Pranav-s19/Autonomous-Robotic-Arm-for-Warehouse-Logistics-Using-TinyML/README.md

# Autonomous-Robotic-Arm-for-Warehouse-Logistics-Using-TinyML

***Public Project Link:***  https://studio.edgeimpulse.com/public/827532/live

***Project Demo Video:*** https://www.youtube.com/watch?v=fI1cnPdgFPI

## Introduction

Modern warehouses require fast, reliable, and intelligent sorting systems to manage increasing demand. Traditional automated solutions are often expensive, power-hungry, and rely heavily on cloud connectivity, making them unsuitable for small-scale industries or secure in-house environments.
This project presents a TinyML-powered autonomous robotic arm capable of detecting, classifying, and sorting boxes using only low-power microcontrollers and edge intelligence.

## Motivation

The primary motivation behind this project is to build a cost-efficient, energy-efficient, and memory-efficient autonomous warehouse solution that operates entirely on edge devices. With an increasing need for secure in-house computation—especially in industries where data privacy is critical—this system eliminates cloud dependency while maintaining smart functionality.
The entire prototype has been developed using minimal resources and low-cost components, proving that advanced warehouse automation is achievable even with limited budgets. This project showcases how TinyML and embedded systems can enable scalable, secure, and sustainable industrial automation.

## Hardware Selection

- ESP32-CAM (AI Thinker)
- ESP32 XIAO S3
- Arduino Nano
- 28BYJ-48 Stepper Motor DC 5V  
- MG945 Servo 
- MG90S Servo 
- SG90 Servo 
- LDR Sensors (x2)
- 10kΩ Variable Resistors (x2)
- Red LED 
- Yellow LED 
- 3mm Sunboard Sheet
- Jumper Wires
- Breadboard (x2)
- USB Data Cables
- Power Supply (5V 3A)
- DC–DC Voltage Converter (5V → 3.3V)
- LM2596S Buck Converter

## Software & Platforms

- Arduino IDE
- Edge Impulse

#### The project follows a two-phase architecture: 
>In the first phase, development of object detection model in Edge Impulse to classify apple and mango boxes using the ESP32-CAM. 

>In the second phase, object detection model is integrated into a coordinated multi-microcontroller system that handles decision-making and autonomous robotic arm movement.

```bash
Architecture
│
├── Object detection Model Development
│   ├── Data Acquisition
│   ├── Impulse Design
│   └── Model Training & Deployment
│
└── Hardware Integration & Application
    ├── ESP32-CAM (Inference)
    ├── ESP32 XIAO S3 (Decision Control)
    └── Arduino Nano + Robotic Arm (Motion Control)
```

## Object Detection Model Development

### Data Acquisition
I collected my dataset directly using the ESP32-CAM, which I configured as a small web server using the EloquentESP32CAM library. I captured at least 130 images per class (apple and mango boxes) under constant lighting and a clean background. The images were taken at a resolution of 240×240 px, which is suitable for fast training and edge deployment. After capturing, I downloaded the images and uploaded them to Edge Impulse for labeling.

For more details on ESP32-CAM data collection: https://eloquentarduino.com/posts/esp32-cam-object-detection

>  **Note:** while capturing images, I turned on Built-in LED flash for consistent lighting.

In the Labelling queue, all the raw images are shown, and we need to drag and drop the markings and label the boxes accordingly.

You can learn more about the labeling queue here: https://docs.edgeimpulse.com/studio/projects/data-acquisition/labeling-queue.

### Impulse Design

I selected the Image input block with a resolution of 96×96 and chose Fit longest axis. Smaller size makes the model lightweight and faster to run on the ESP32-CAM while still keeping enough detail. for classifying apple and mango boxes.

For the learning block, I selected Object Detection (Images).

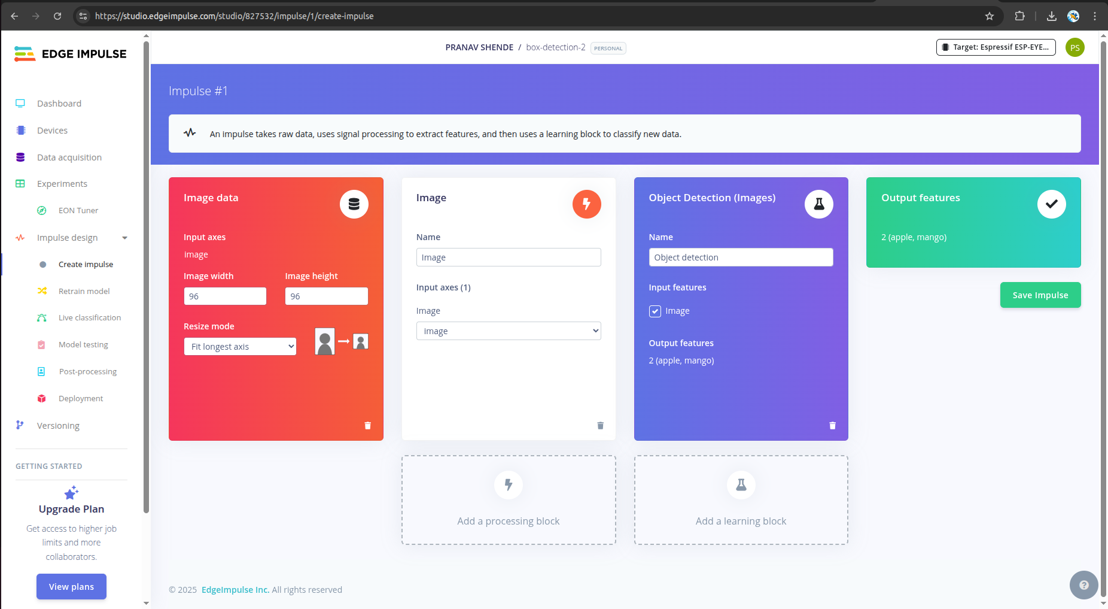
[picture p1: images/create impulse.png]
<ln/>

Then on the Image section, I selected the color depth as “ Grayscale”.<br/>
Grayscale reduces memory usage and speeds up inference while still keeping enough features for classification.

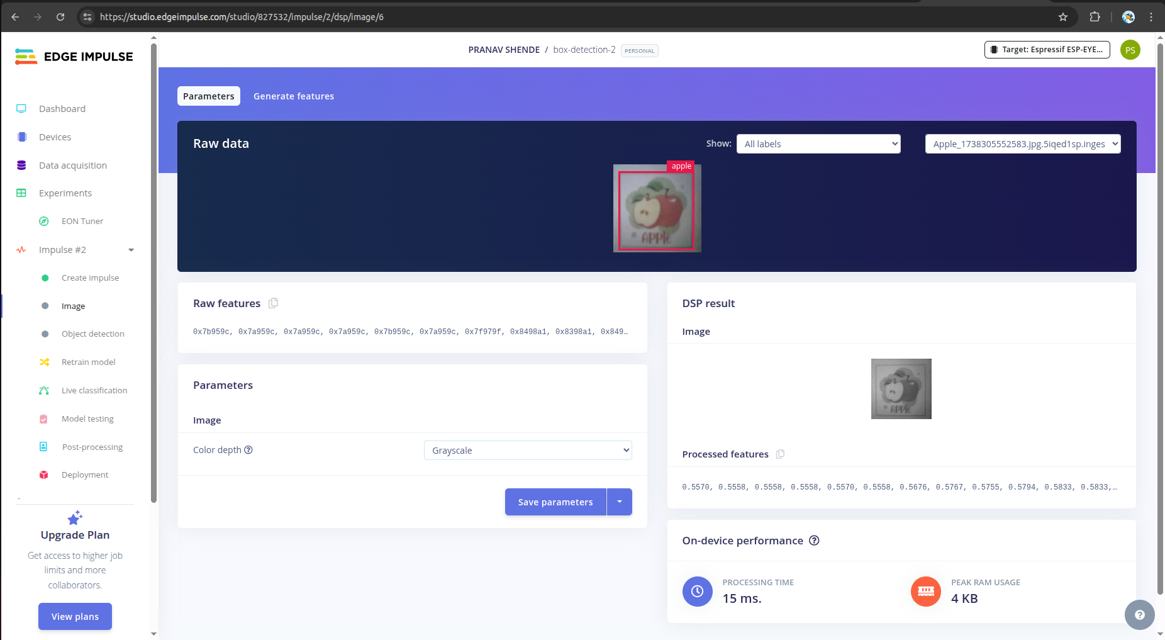
[picture p2: images/grayscale.png]
<ln/>

### Model Training

I trained the model for 40 epochs with a learning rate of 0.001, which gave a good balance between speed and stability.<br/>
In the Object detection section, I have selected the FOMO model — FOMO (Faster Objects, More Objects) MobileNetV2 0.35 

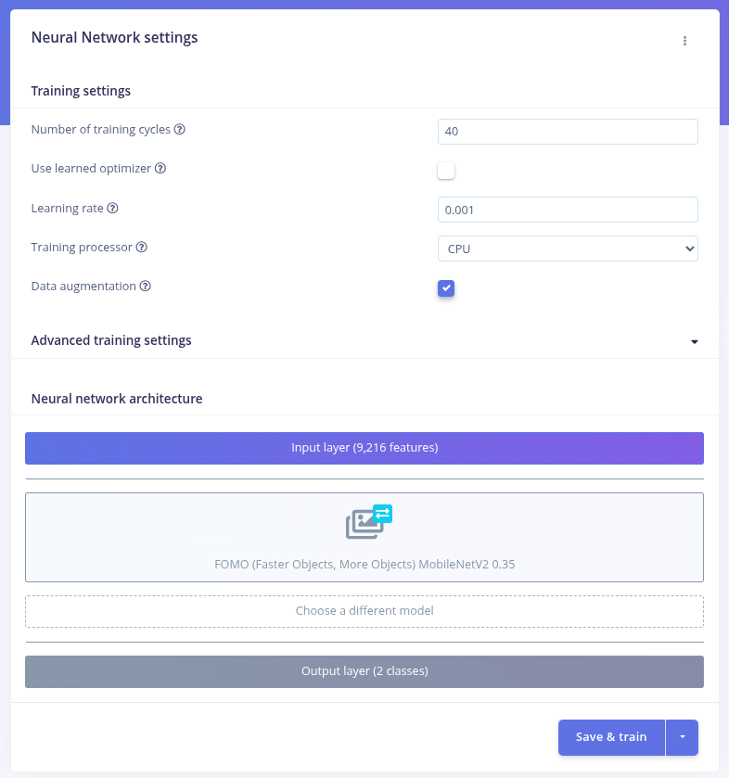
[picture p3: images/training-param.png]
 <ln/>

After training, the model achieved an accuracy of around 97.6% on the validation set, which is sufficient for reliable classification in this application.

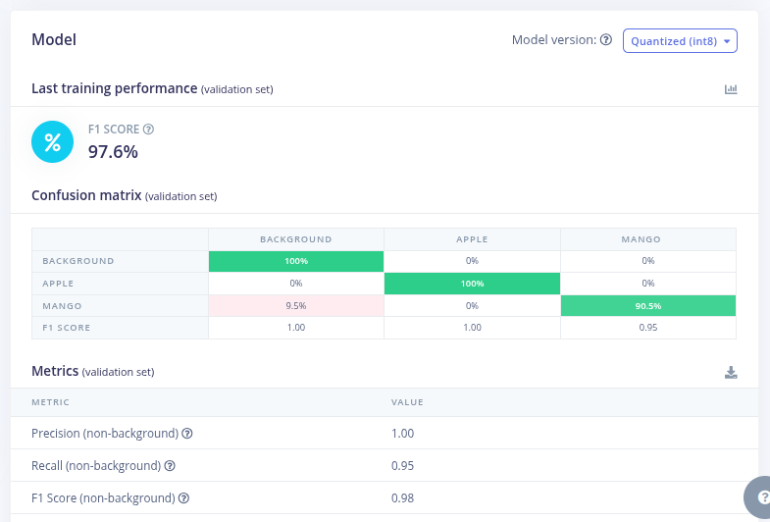
[picture p4: images/training output.png]


### Model Testing
After testing model on unseen image data, achieved 100% accuracy.

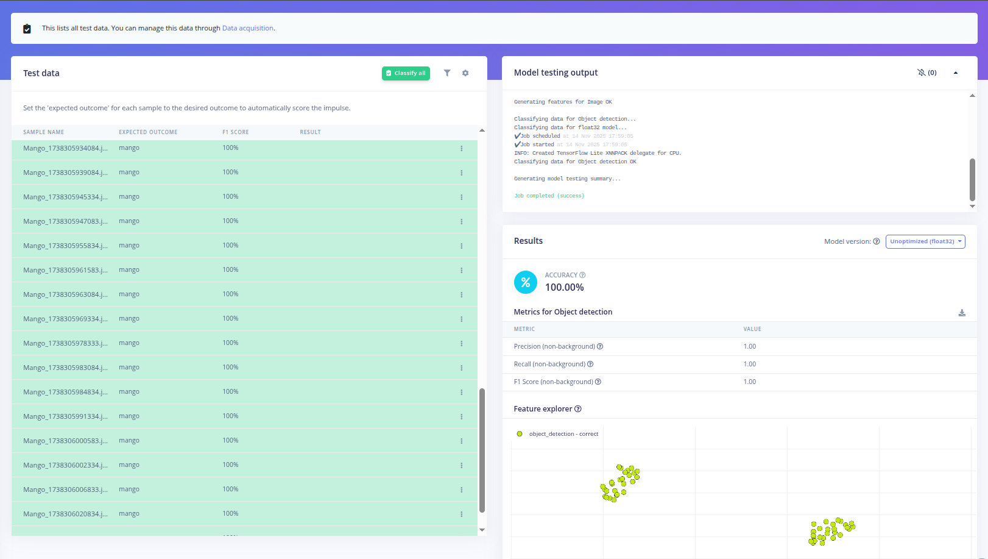
[picture p5: images/testing.png]
<ln/>

>  **Note:** I tested multiple models using the same dataset but with different image sizes, dataset sizes and impulse configurations. Some models showed high accuracy inside Edge Impulse, while others showed lower accuracy. However, when deploying them on the ESP32-CAM, the results were different — models with lower reported accuracy sometimes performed better in real conditions, and vice-versa. Hence, the true performance can only be judged after actual deployment on the device. The model I selected above delivered the most reliable results in the real application.

### Model Deployment

In Deployment section, build Arduino library and downloaded using the Quantized (int8) option for efficient on-device execution.

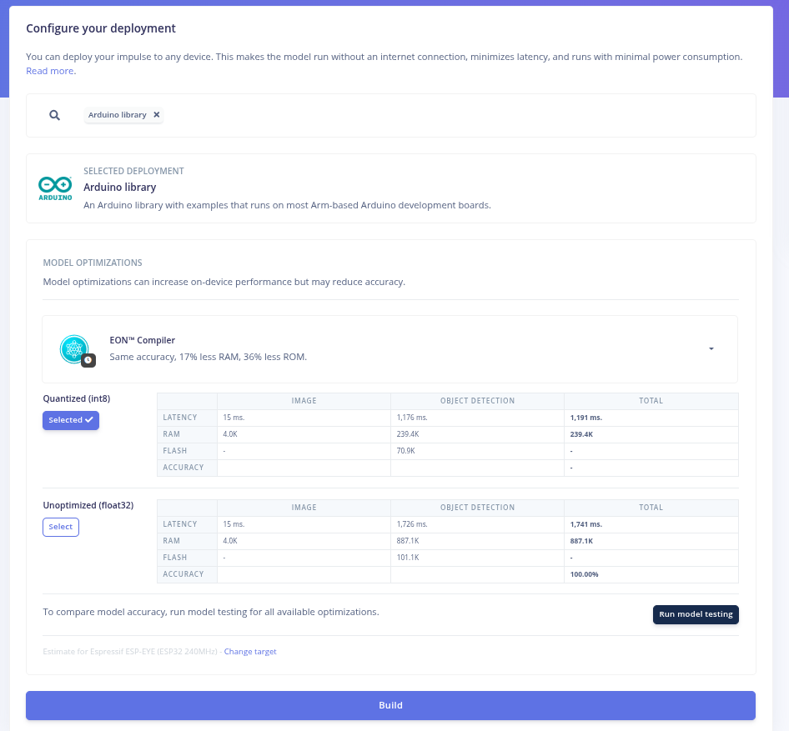
[picture p6: images/deployment.png]
 <ln/>

> **Note:** EON Compiler is selected by default which will reduce the amount of memory required for our model.

## Hardware Integration & Application
```bash
System-Workflow
├── ESP32-CAM
│   ├── Captures image
│   ├── Runs TinyML object detection
│   ├── Checks confidence > 75%
│   └── Sends Apple/Mango GPIO trigger → ESP32-XIAO-S3
│
├── ESP32-XIAO-S3
│   ├── Receives trigger from ESP32-CAM
│   ├── Reads LDR sensors (storage empty/full)
│   ├── Controls Red/Yellow LEDs
│   └── Sends clean Apple/Mango signal → Arduino-Nano
│
└── Arduino-Nano
    ├── Receives trigger signal
    ├── Executes Apple/Mango pick-and-place routine
    └── Controls stepper + servo motors for arm movement

```
### ESP32-CAM (Inference)

Object detection model deployed to the ESP32-CAM board’s flash, so every image it captures is classified on the device itself. 

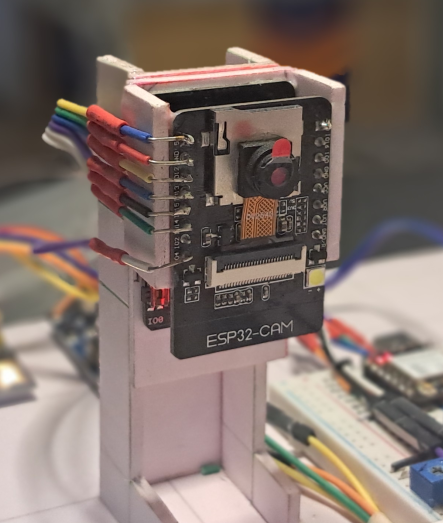
[picture p7: images/applied-esp32-cam.png]
<ln/>

To avoid wrong detections, I kept a 75% confidence limit, if the confidence is high enough, it activates the corresponding GPIO pin to notify the ESP32 XIAO S3.

```bash
// Apple detection logic with 75% confidence threshold 
if (bb.label=="apple" && bb.value > 0.75) {
        digitalWrite(AppleTrig, HIGH);  
    }
    else {
       digitalWrite(AppleTrig, LOW);
    }
// Mango detection logic with 75% confidence threshold 
if (bb.label== "mango" && bb.value > 0.75) {
        digitalWrite(MangoTrig, HIGH); 
    } 
    else {
        digitalWrite(MangoTrig, LOW);
    }
```
Code Logic Inspiration: https://forum.edgeimpulse.com/t/led-blink-with-esp32-cam-and-object-detection/11919

An OLED display is integrated to show live classification results with confidence values, making it easy to verify predictions without relying on a serial terminal.

<ln/>

To ensure consistent visual conditions, especially in indoor warehouse environments, the ESP32-CAM uses its onboard flash LED, which can be manually enabled through a push button. This eliminates shadows and lighting variations, helping the model maintain stable accuracy in indoor warehouse environments.

<ln/>

#### Code For ESP32-CAM: [View ESP32-CAM Code](code/esp32_cam.ino)

### ESP32 XIAO S3 (Decision Control)

The ESP32 XIAO S3 handles all the decision-level features in the system. It reads the trigger signals coming from the ESP32-CAM. These triggers represent the final classification result apple or mango and are used by the XIAO to decide which pick-and-place action needs to follow. By separating the vision task (handled by ESP32-CAM) from the decision task (handled by XIAO), the system stays modular and avoids any timing conflicts.

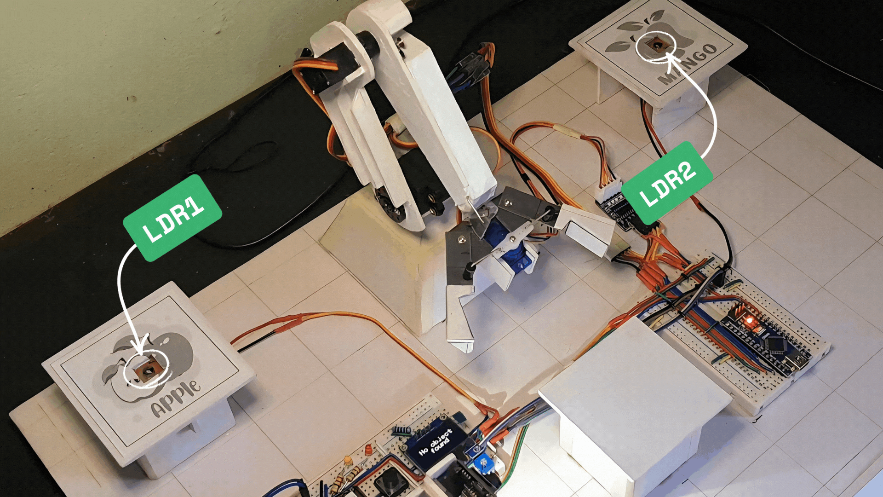
[picture p8: images/ldr.gif]
<ln/>

LDR sensors placed on the storage units. Each LDR tells whether the apple or mango storage space is empty or already filled with a box. Because LDR readings depend on light intensity, I added a 10kΩ variable resistor to each sensor so I can easily adjust their sensitivity. This ensures that the XIAO always receives accurate information, no matter the ambient lighting conditions.

The use of two indicator LEDs—Red(LED2) for the apple unit and Yellow(LED1) for the mango unit, these LEDs turn on whenever their corresponding storage unit is full. This helps me quickly understand the status of each unit without checking the serial output, and it also makes the system more user-friendly during testing.

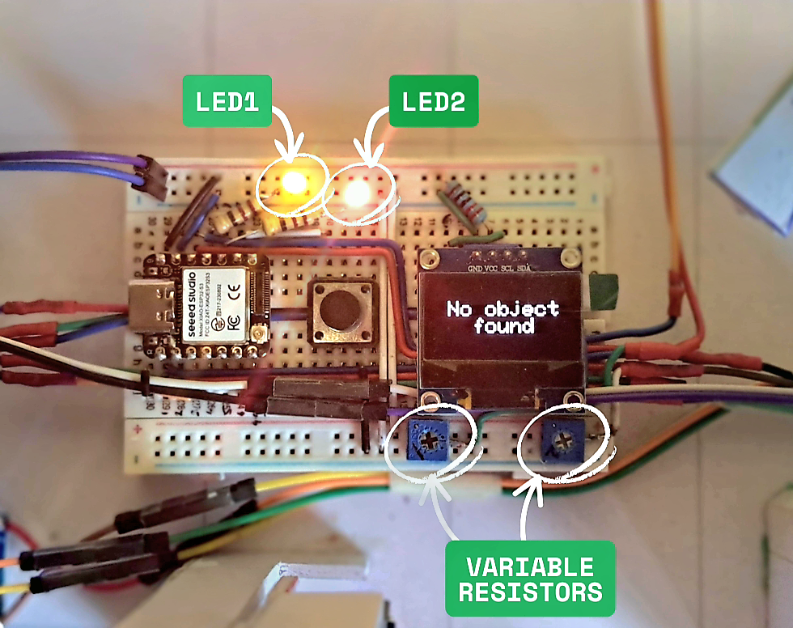
[picture p9: images/Variable resistor.png]
<ln/>

#### Code For ESP32-XIAO: [View ESP32-XIAO Code](code/esp32_xiao.ino)

### Arduino Nano + Robotic Arm (Motion Control)

The Arduino Nano is responsible for controlling the entire motion sequence of the robotic arm. It drives four different actuators: a 5V stepper motor at the base for horizontal rotation, an MG945 servo at the shoulder, an MG90S at the elbow, and an SG90 at the gripper. Each motor has a predefined position and timing that together form the complete pick-and-place movement. By keeping this motion logic inside the Nano, the mechanical control stays smooth and independent of the higher-level decision flow.

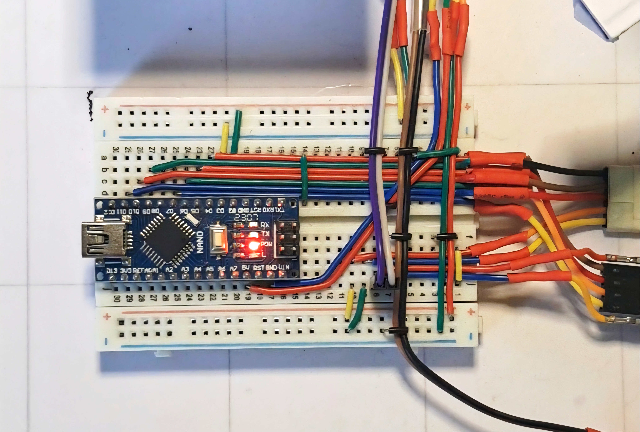
[picture p10: images/arduino-nano-a.jpg]
<ln/>

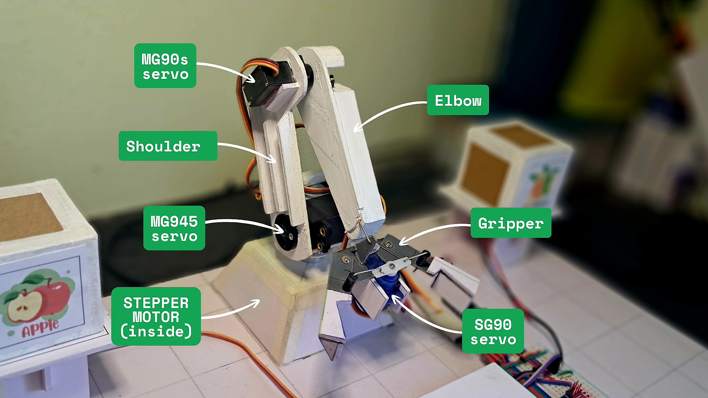
[picture p11: images/arm.png]
<ln/>

The robotic arm used in this project is completely custom-built by hand using 3 mm sunboard sheets. Instead of relying on 3D printing or expensive mechanical parts, I designed, cut, and assembled the entire structure manually to keep the prototype lightweight, low-cost, and easy to modify. Each joint was carefully aligned to ensure smooth movement with the servos and stepper motor, making the arm both functional and practical for warehouse sorting tasks while maintaining full DIY flexibility.

```bash
// --- Parallel Robotic Arm Control (Non-Blocking) ---

if (buttonPressed1) {
    unsigned long currentMillis = millis();

    switch (stepState) {

      // ---- STEP 0: Move Servo1 & Servo2 together ----
      case 0:
        if (currentMillis - previousMillis1 >= stepDelayServo1) {
          previousMillis1 = currentMillis;
          if (servo1Angle > 140) { servo1Angle--; servo1.write(servo1Angle); }
        }
        if (currentMillis - previousMillis2 >= stepDelayServo2) {
          previousMillis2 = currentMillis;
          if (servo2Angle > 155) { servo2Angle--; servo2.write(servo2Angle); }
        }
        if (servo1Angle == 140 && servo2Angle == 155) stepState++;
        break;

      // ---- STEP 1: Move Servo3 down ----
      case 1:
        if (currentMillis - previousMillis3 >= stepDelayServo3) {
          previousMillis3 = currentMillis;
          if (servo3Angle > 20) { servo3Angle--; servo3.write(servo3Angle); }
          else stepState++;
        }
        break;

      // ---- STEP 2: Servo2 adjusts for grip ----
      case 2:
        if (currentMillis - previousMillis2 >= stepDelayServo2) {
          previousMillis2 = currentMillis;
          if (servo2Angle < 175) { servo2Angle++; servo2.write(servo2Angle); }
          else stepState++;
        }
        break;

      // ---- STEP 3: Stepper rotates 90° ----
      case 3:
        if (currentMillis - previousMillisStepper >= interval) {
          previousMillisStepper = currentMillis;
          stepper.step(stepsPerRevolution / 4);
          stepState++;
        }
        break;

      // ---- STEP 4: Servo2 correction ----
      case 4:
        if (currentMillis - previousMillis2 >= stepDelayServo2) {
          previousMillis2 = currentMillis;
          if (servo2Angle > 155) { servo2Angle--; servo2.write(servo2Angle); }
          else stepState++;
        }
        break;

      // ---- STEP 5: Lift Servo3 back to 90° ----
      case 5:
        if (currentMillis - previousMillis3 >= stepDelayServo3) {
          previousMillis3 = currentMillis;
          if (servo3Angle < 90) { servo3Angle++; servo3.write(servo3Angle); }
          else stepState++;
        }
        break;

      // ---- STEP 6: Servo1 & Servo2 return together ----
      case 6:
        if (currentMillis - previousMillis1 >= stepDelayServo1) {
          previousMillis1 = currentMillis;
          if (servo1Angle < 180) { servo1Angle++; servo1.write(servo1Angle); }
        }
        if (currentMillis - previousMillis2 >= stepDelayServo2) {
          previousMillis2 = currentMillis;
          if (servo2Angle < 180) { servo2Angle++; servo2.write(servo2Angle); }
        }
        if (servo1Angle == 180 && servo2Angle == 180) stepState++;
        break;

      // ---- STEP 7: Stepper moves back to default ----
      case 7:
        if (currentMillis - previousMillisStepper >= interval) {
          previousMillisStepper = currentMillis;
          stepper.step(-stepsPerRevolution / 4);  
        }
        buttonPressed1 = false;     // Reset cycle
        break;
    }
}
```

To control the robotic arm smoothly, I used a non-blocking, parallel-execution approach based on millis(), which allows all servos and the stepper motor to move in parallel. Instead of using delays, each motor runs on its own timed loop, coordinated by a simple state machine. This makes the arm move smoothly and simultaneously, similar to real industrial robotic arms.

<ln/>

Based on which GPIO pin the ESP32 XIAO S3 activates, the Nano decides which predefined path to run. This lets the arm rotate to the correct pickup location, lower itself, grip the box, lift, and place it precisely in the correct storage unit before returning home. Each path is tuned to match the physical layout of the arm and the storage placement.

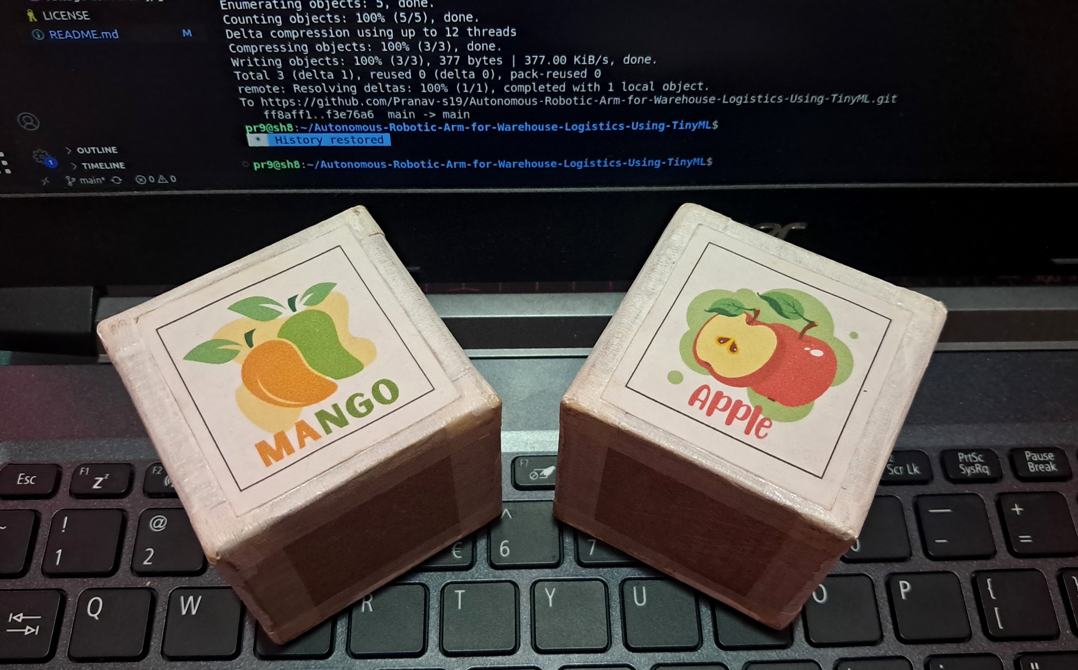
[picture p12: images/boxes.jpg]
<ln/>
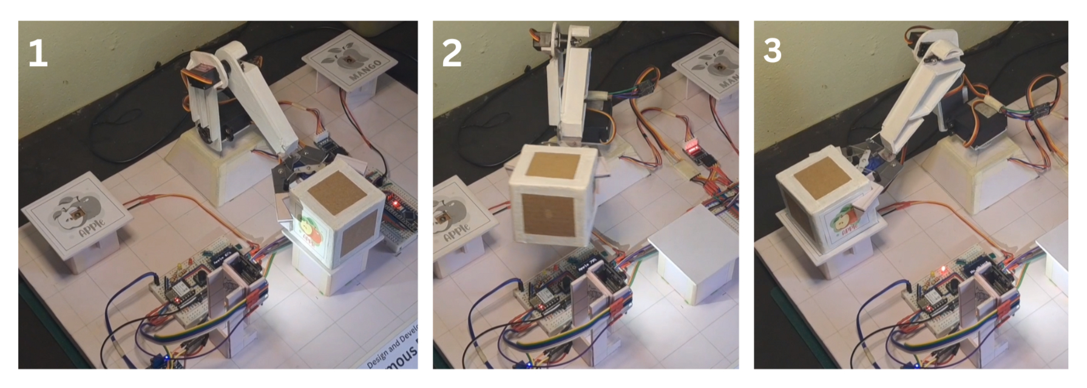
[picture p13: images/pick-place-op.png]


#### Code For Arduino Nano: [View Arduino Nano Code](code/arduino_nano.ino)

### Power Supply

The entire system is powered using a 5V 3A DC adapter, which provides sufficient current for the ESP32 modules, Arduino Nano, servos, and the stepper motor.
To ensure each component receives the correct voltage, the following DC–DC converters are used:

 **A LM2596S buck converter :**  Regulates a stable 5V supply for the robotic arm motors, preventing voltage drops when the servos and stepper motor draw higher current. 

 **DC–DC Voltage Converter (5V → 3.3V) :**  Used to safely power low-voltage modules such as ESP32-CAM or ESP32-XIAO when needed.

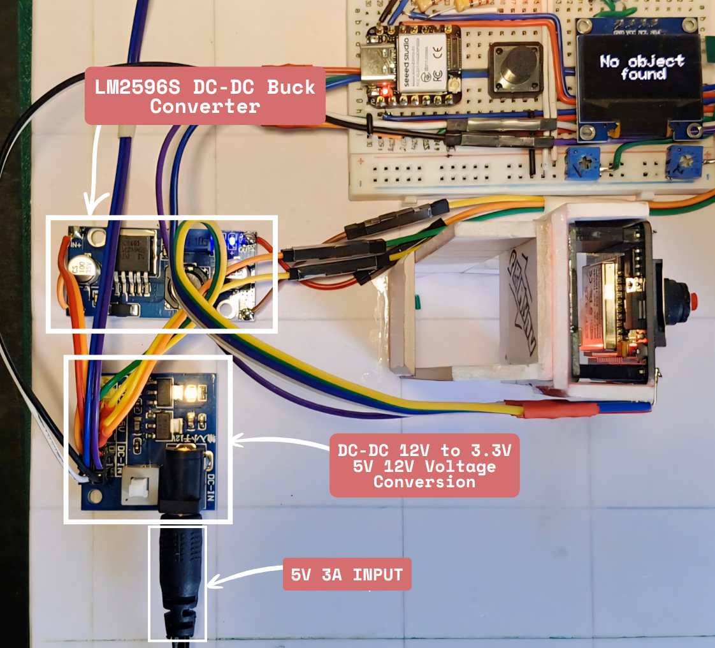
[picture p14: images/power-supply.png]
 

### Future Updates & Improvements

#### Improve Object Classification
The current model works for two classes—apple and mango. In future versions, we can expand the system to classify more box types or detect different product categories, making the arm more versatile for real warehouse environments.

#### Enhance Camera Pipeline & Lighting Control
The detection accuracy can be further improved by upgrading the camera pipeline—such as using adaptive exposure or a higher-quality lens module. Automatic lighting adjustment can also be added so the ESP32-CAM dynamically manages brightness without requiring manual flash control.

#### Replace LDR Sensors With More Reliable Options
LDR sensors depend heavily on light intensity and require manual tuning through variable resistors. In future versions, we can replace them with more reliable sensors like IR proximity, break-beam, or ultrasonic sensors, which do not change with ambient lighting.
Alternatively, the resistance tuning process can be automated using a digital potentiometer so the system self-adjusts based on environment conditions.

## Project Demo Video (click below to play)

Watch the video (https://www.youtube.com/watch?v=fI1cnPdgFPI)

### Conclusion

This project demonstrates how low-cost microcontrollers and TinyML can be combined to build a fully autonomous warehouse sorting system without relying on cloud processing or expensive industrial hardware. By distributing tasks across the ESP32-CAM, ESP32 XIAO S3, and Arduino Nano, the system achieves reliable edge-based object detection, smart decision-making, and precise robotic arm control.
