Pranav-s19/Autonomous-Robotic-Arm-for-Warehouse-Logistics-Using-TinyML/images/esp32-xiao-s3.jpg

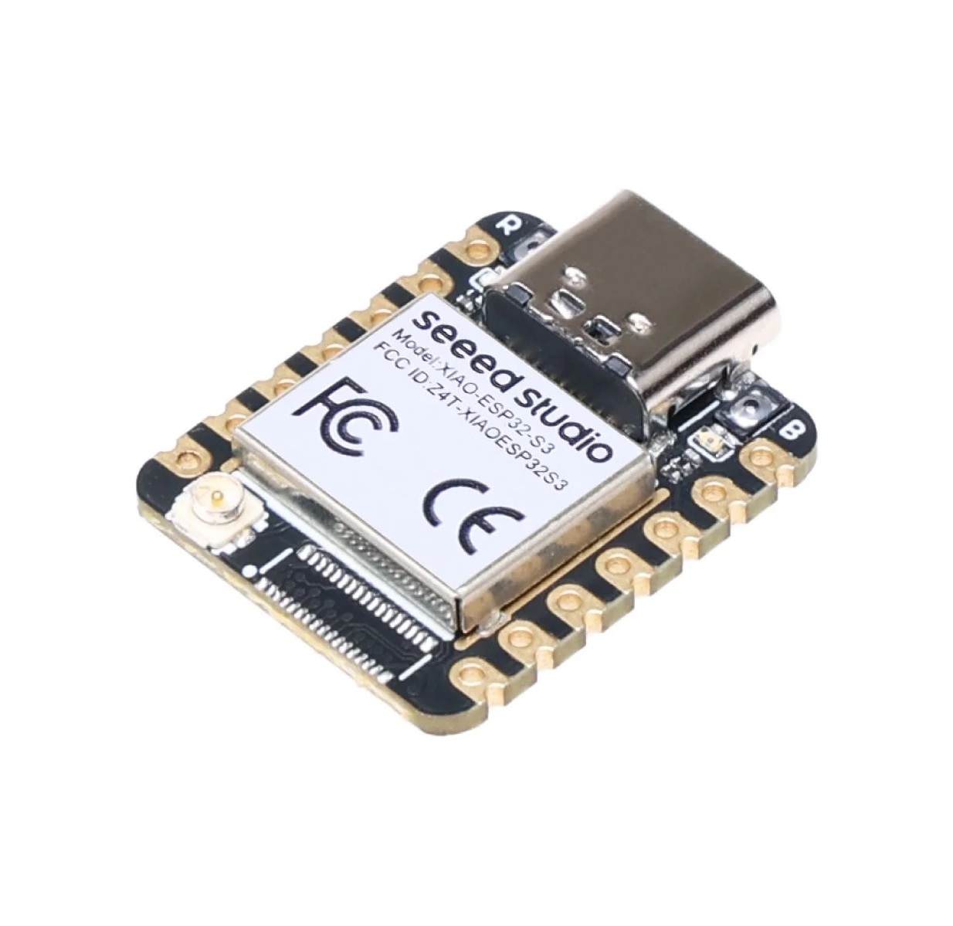
images/esp32-xiao-s3.jpg
