Pranav-s19/Autonomous-Robotic-Arm-for-Warehouse-Logistics-Using-TinyML/images/generate features.png

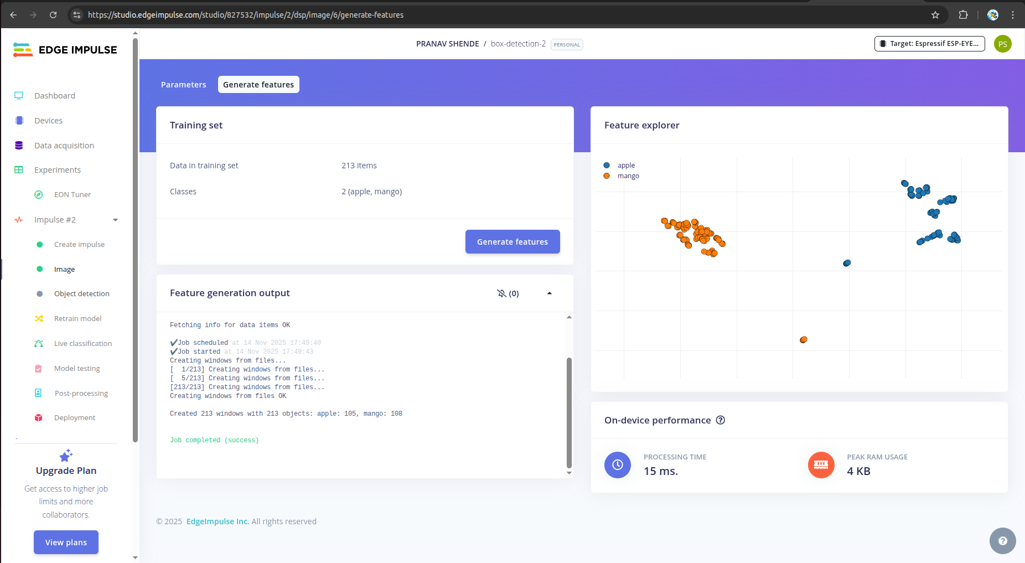
images/generate features.png
