Pranav-s19/Autonomous-Robotic-Arm-for-Warehouse-Logistics-Using-TinyML/images/ldr-sensor.webp

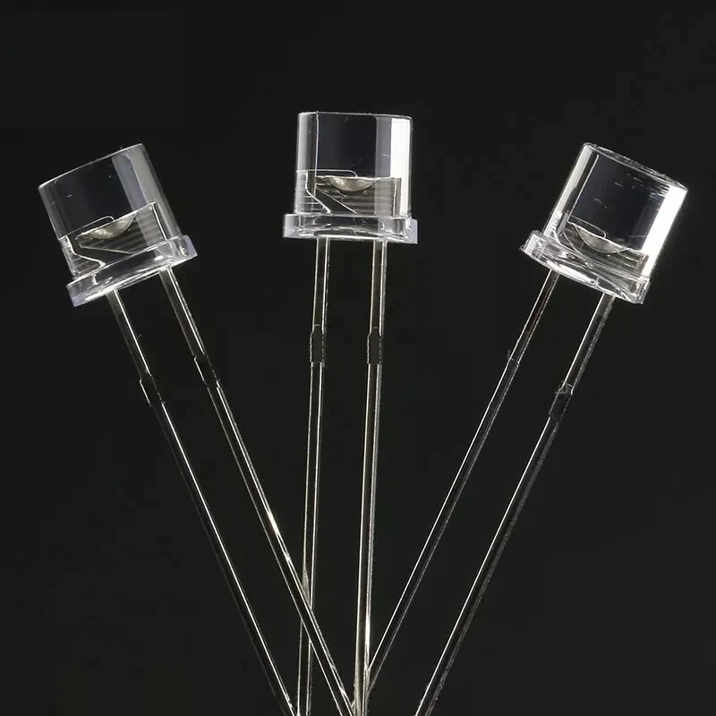
images/ldr-sensor.webp
