Pranav-s19/Autonomous-Robotic-Arm-for-Warehouse-Logistics-Using-TinyML/images/robotic-arm.png

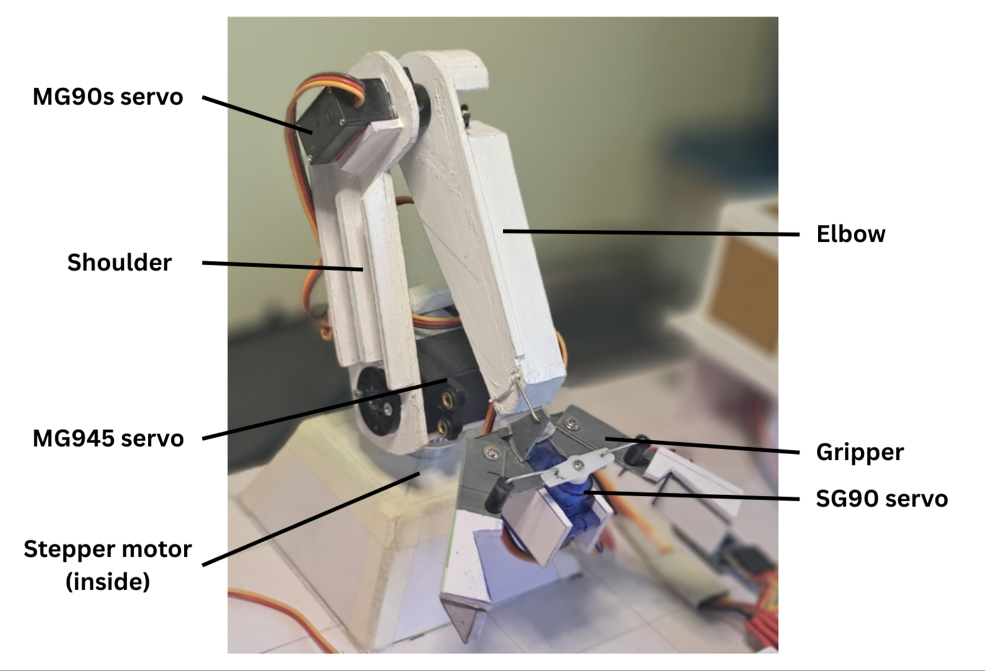
images/robotic-arm.png
