Pranav-s19/Autonomous-Robotic-Arm-for-Warehouse-Logistics-Using-TinyML/images/voltage-converter.jpg

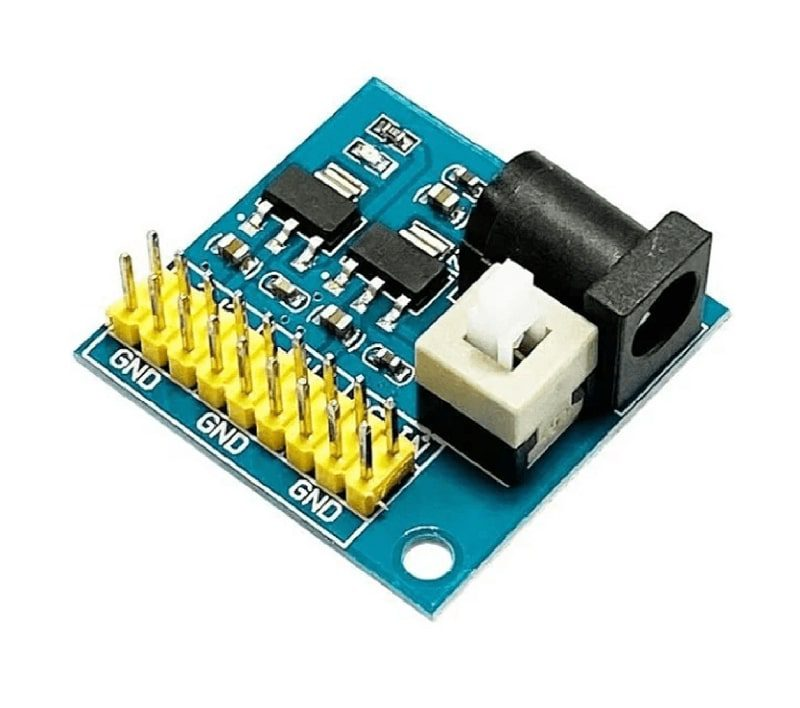
images/voltage-converter.jpg
